retrocityransom/snengine/media/photos/snengine_assembly_91_small.jpg

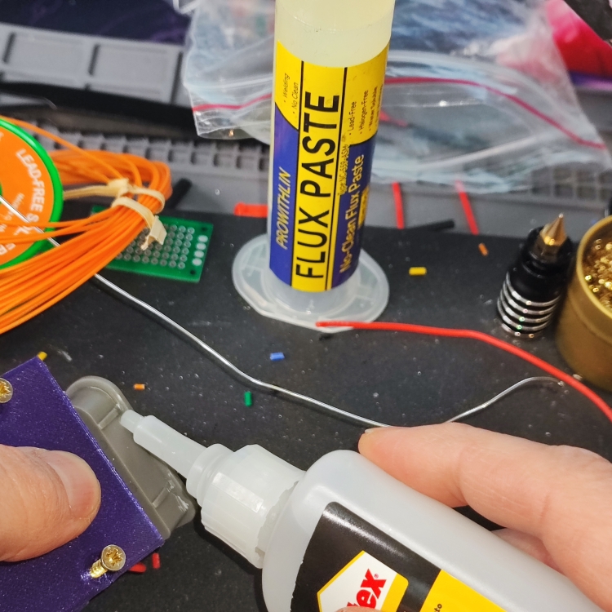
media/photos/snengine_assembly_91_small.jpg
