retrocityransom/snengine/media/photos/snengine_assembly_92_small.jpg

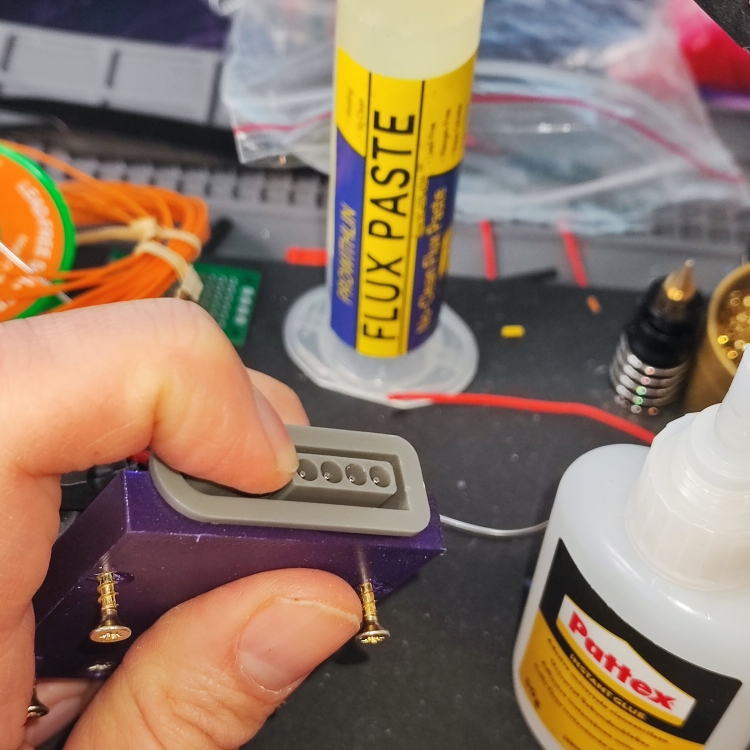
media/photos/snengine_assembly_92_small.jpg
