retrocityransom/snengine/(commit log)

2026-03-23 New button mappings, persistent settings and small fixes in cheat sheet
    [SNEngine_Cheat_Sheet_Example.ods]
2026-03-28 SN30 Fix + Optimizations
    [SNEngine__20260328-1_nosync_lagopt_SN30fix.ino]
2026-04-02 Added more autofire options, made it easier to extend button mappings, hopefully reduced a bit of lag
2026-04-05 Removed not sending SELECT when pressing hotkeys to fix FMT cheat menu
    [SNEngine__20260402-3_nosync_faster_timing_new_autofire_modes.ino]
2026-04-11 Added OLED support, enhanced hotkey handling, avoids unecessary saves now
    [SNEngine__20260409-4_oled.ino]
2026-04-13 Added OLED diagrams, updated pinout for OLED, added splash screen
    [SNEngine_Cheat_Sheet_Example.ods]
2026-04-15 Added display for XBOX and PSX controller buttons
